ggavinowich/CESE_PCB_poncho_CAN/(commit log)

2018-09-21 Primera version del esquematico
    Todos los componentes agregados.
    Falta:
    - Reordenar todo
    - Decidir los jumpers a utilizar
    [poncho_can.kicad_pcb, poncho_can.sch]
2018-09-29 Agrego la proteccion en el esquematico
    [poncho_can.sch]
2018-10-04 Selección de footprints y ubicacion de componentes
    [_saved_poncho_can.sch, poncho_can.kicad_pcb]
2018-10-05 Ruteada una mitad.
    Falta cambiar el tamaño de la placa.
    Verificar las distancias.
    Hacer el cooper pour
    [poncho_can.kicad_pcb]
2018-10-09 Improved PCB
    [_saved_poncho_can.sch, poncho_can.kicad_pcb, poncho_can.sch]
2018-10-09 Cambio los jumpers de lugar en el esquematico y agrego leds en RX y TX
    [poncho_can.sch]
2018-10-09 Agreo la interconexion de las masas y las alimentaciones que habia borrado
    [poncho_can.sch]
2018-10-09 Agrego en el esquematico las señales de CAN como par diferencial
    [poncho_can.sch]
2018-10-09 Muevo los leds del otro lado de los jumpers de goteo
    [poncho_can.sch]
2018-10-09 Nueva colocación de los componentes
    [poncho_can.kicad_pcb]
2018-10-10 Ruteo de los componentes
    [poncho_can.kicad_pcb, poncho_can.sch]
2018-10-12 Fin de esquematico y agrego los gerbers
    [poncho_can-B.Adhes.gbr, poncho_can-B.CrtYd.gbr, poncho_can-B.Cu.gbr, poncho_can-B.Fab.gbr, poncho_can-B.Mask.gbr, poncho_can-B.Paste.gbr, poncho_can-B.SilkS.gbr, poncho_can-Cmts.User.gbr]
2018-10-19 Agrego documentacion y aplica cambios sugeridos en la revision
    [poncho_can.kicad_pcb, poncho_can.sch]
2018-10-19 Rehago el fill de cobre para que quede bien indicado en la placa. Edito las comentarios en el pcb con el valor del clearence corregido
    [poncho_can.kicad_pcb]
2018-10-20 Agrego texto Industria Argentina, y el fill de la mascara sobre el texto
    [poncho_can.kicad_pcb]
2018-10-20 Agrego el numero de parte de Digikey para todos los componentes
    [poncho_can.sch]
2018-10-20 Agrego los modelos 3D a una carpeta local y reasigno los footprints de esa carpeta
    [poncho_can.kicad_pcb]
2018-10-20 Agrego al ruta 3D de un resistor que me faltó
    [poncho_can.kicad_pcb]
2018-10-30 Multiples correcciones:
    - Se removió segunda licencia en la raiz
    - Se corrigió licencia en doc/licencia
    - Se agrego la información de la licencia al rótulo del esquemático y pcb
    - Se escondieron las serigrafias de los fiduciarios
    - Se movio la serigrafia de J101 y J102
    - Se agregó la información del fabricante
    - Se agregó la información de la terminación
    [poncho_can.kicad_pcb, poncho_can.sch]
